totorodad/record_player_motor_driver/README.md

# record_player_motor_driver
Arduino code to drive h-bridge for speed controlling record player with hall effect sensor
