totorodad/record_player_motor_driver/speed control circuit rev 0.pdf

# Auto speed control for Gemini Vinyl2mp3 record player

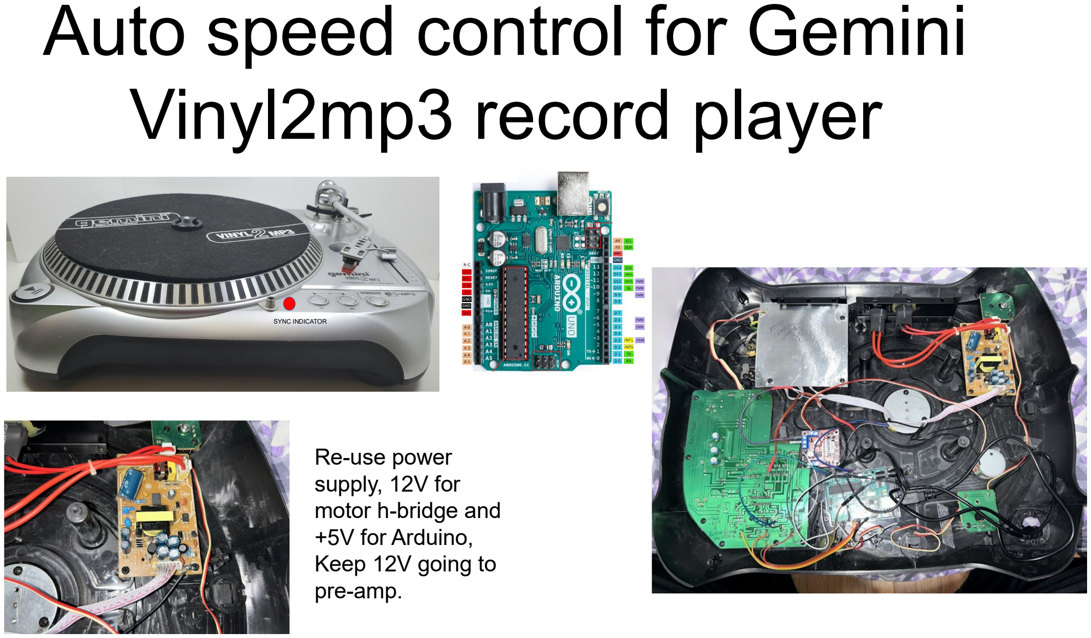
[picture p1: page 1]

SYNC INDICATOR

+5V

Re-use power
supply, 12V for
motor h-bridge and
+5V for Arduino,
Keep 12V going to
pre-amp.

# Place Hall Sensor Target Magnet on Record Player Platter

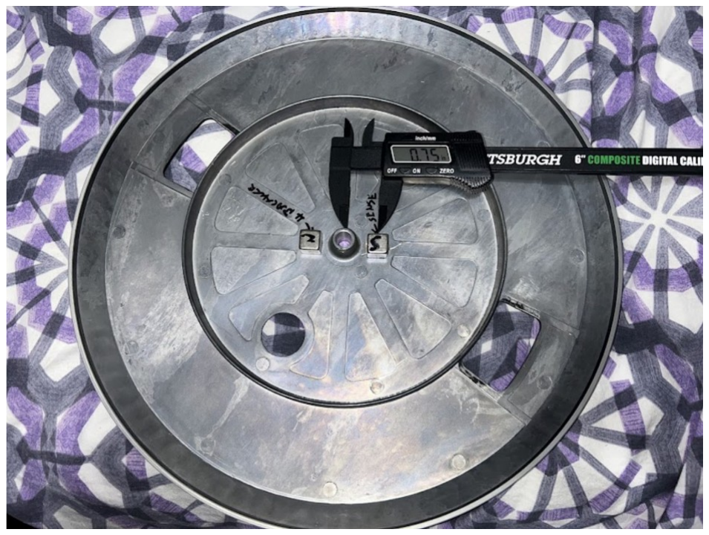
[picture p2: figure]

- Glue hall sensor target magnet on the underside of the aluminum platter near the center such that the platter spins freely on the center bearing at approx. R=.75-.9 in. from the center of the platter works for a .5”x.5”x.5” rare earth magnet. Use hot melt glue.
- The magnet must not be allowed to be close to the cartridge generator or the generator magnets will be attracted to the hall sensor target magnet and disturb the tone arm.
- Balance the platter by putting an equal counter wight to the magnet on the opposite side of the underside of the platter.
- Add wire extension to the hall sensor with shrink tube to protect the lead and then glue hall sensor under the area where the magnet crosses on the inside of the top deck off the record player at the same R=.75-.9 in.

# Melexis US5881 Hall Sensor From: Adafruit (http://adafu.it/158)

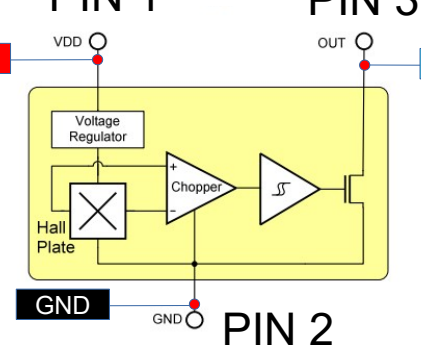
[picture p3: figure]
GND; PIN 2

+5V

PIN 1

D7

PIN 3

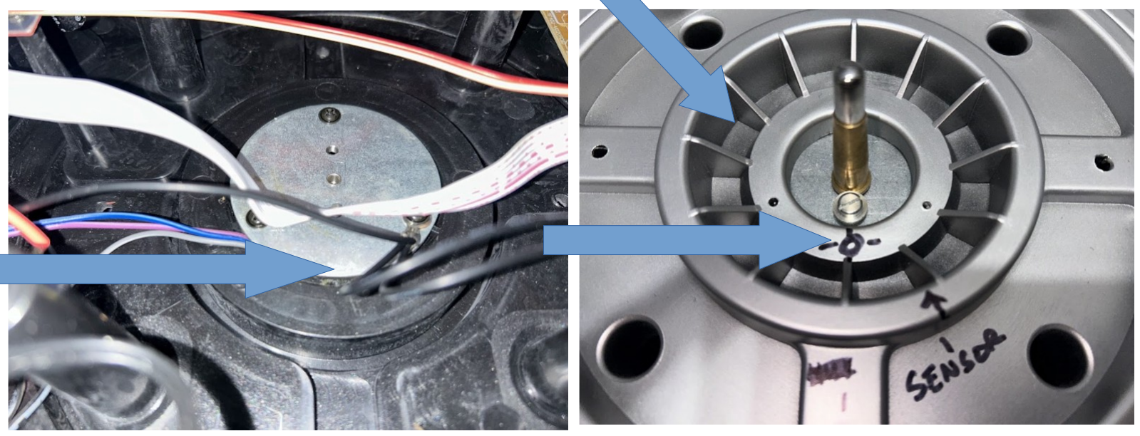
[picture p4: figure]
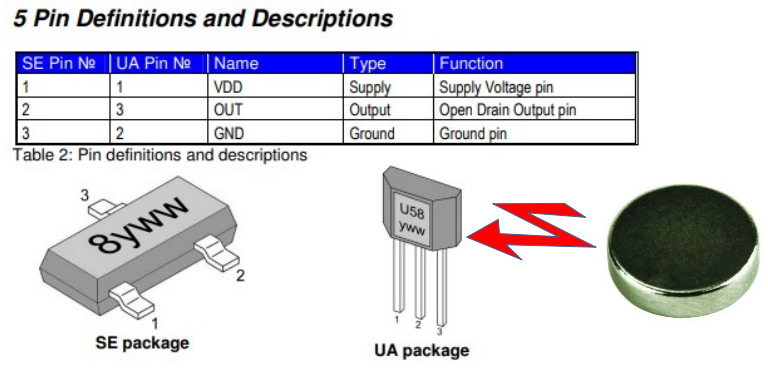
[picture p5: figure]

Note: As an alternate you can get a replacement motor with hall sensor built in. This will control the speed only at the motor rather then the platter which is a little more accurate.

Sensor under
Flange. .75
from center

The target
magnet
sweeps this
volume

# Motor Driver

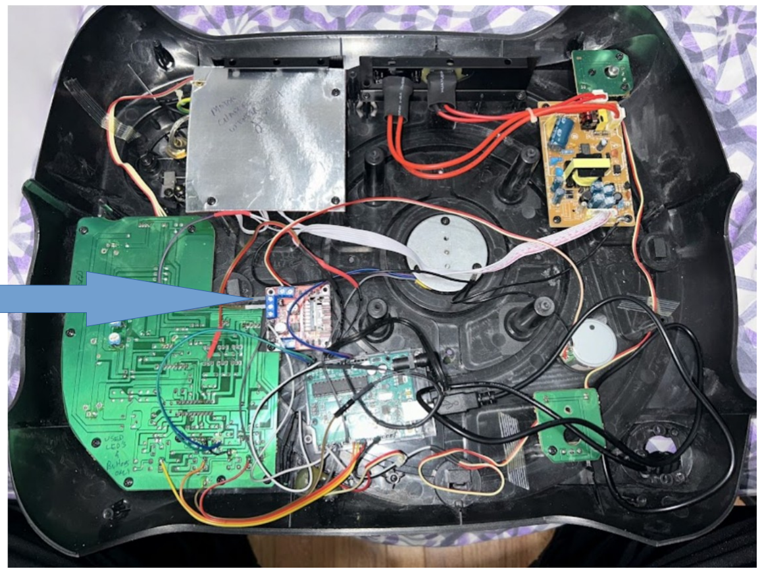
[picture p6: figure]
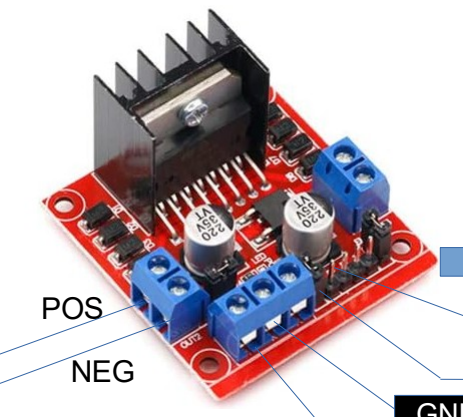
[picture p7: figure]
POS; NEG
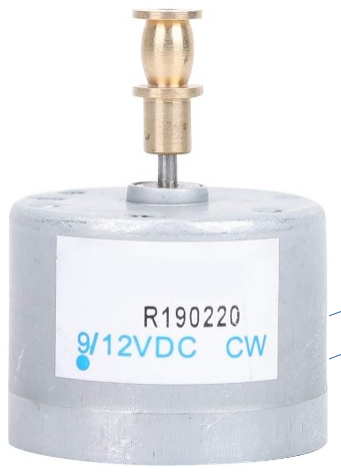
[picture p8: figure]

+12V

IN1 (PWM)

IN2 (PWM)

1) Disable existing motor driver board.
2) Redirect the +5V and +12V from the power supply. +5V to Arduino and +12V to h-bridge driver.
3) Wire existing platter motor to h-bridge (L298N)
4) This h-bridge pcb makes its own +5V

D4
D3

Existing
Motor

GND

## Buttons and LED’s: Modify the old motor controller board to use the existing buttons and LED’s

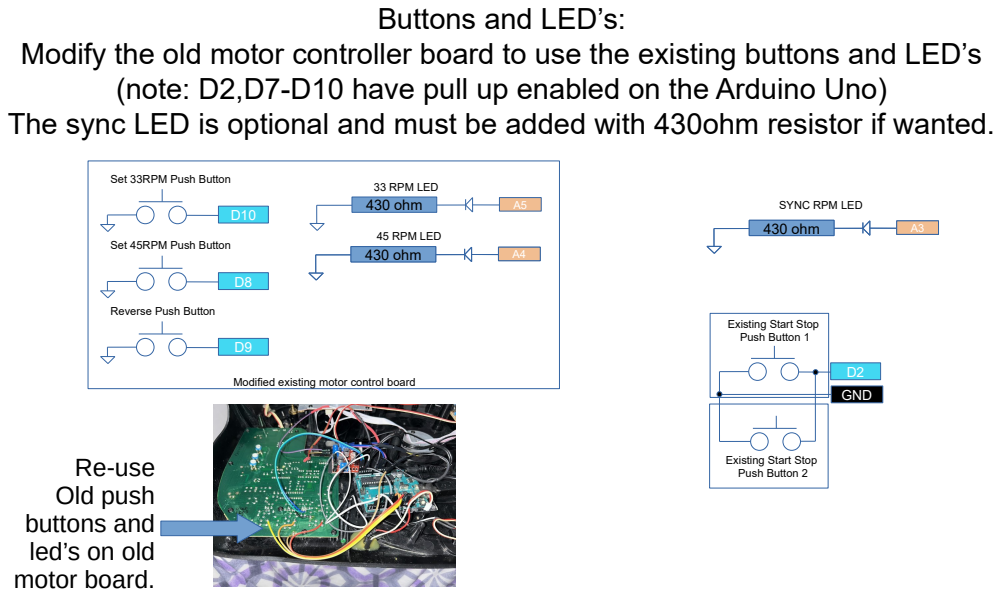
[picture p9: page 5]
430 ohm; 33 RPM LED; 45 RPM LED; GND; Existing Start Stop Re-use; Push Button 2

(note: D2,D7-D10 have pull up enabled on the Arduino Uno)

The sync LED is optional and must be added with 430ohm resistor if wanted.

Set 33RPM Push Button

SYNC RPM LED
430 ohm

Set 45RPM Push Button

Reverse Push Button

Existing Start Stop
Push Button 1

Modified existing motor control board

Old push
buttons and
led’s on old
motor board.

# Software (on Arduino IDE 2.3.3)

# - https://github.com/totorodad/ record_player_motor_driver.git
